EnriqueM11/Proyecto_final_robotica_industrial/README.md

# {Proyecto: Paletizado usando el brazo robotico UR5}



Este proyecto utiliza un robot UR5 para una sola línea de producción automatizada, con el objetivo de optimizar el proceso de empacado. Los sensores integrados en el sistema tienen la capacidad de detectar si los materiales son metálicos o no metálicos. Dependiendo de la detección, un servomotor guiará el objeto hacia la ruta adecuada en el proceso de paletizado. El robot UR5 es responsable de manipular los materiales, garantizando que cada uno se procese correctamente y se coloque en el pallet correspondiente, mejorando la eficiencia y precisión del sistema.

---

## 📋 Requisitos Previos

- Conocimientos necesarios: uso basico de herramientas mecanicas y electronicas, conocimientos basicos de programacion, preferentemente en lenguajes como C/C++ para Arduino y lenguajes de programacion de control de robots, conocimiento en electronica, sistemas de control y automatizacion industrial.

- Herramientas requeridas: cautín para soldadura de componentes electrónicos, maquinaria de manufactura, herramientas basicas (destornillador, pinzas, etc.).

- Componentes electrónicos o mecánicos necesarios: Arduino Mega, sensores inductivo y capacitivo, servomotores, motor de DC, resistencias.

- Software necesario: Arduino IDE, SolidWorks, URSIM.

---

## 📖 Introducción

El propósito de este proyecto es replicar una línea de empacado automatizada utilizando un robot UR5, con el objetivo de optimizar el proceso de paletizado en entornos industriales. En esta línea, los sensores detectan si los materiales son metálicos o no metálicos, y dependiendo de la detección, un servomotor dirige el material a la ruta adecuada. Este sistema automatizado mejora la eficiencia, precisión y seguridad al reducir la intervención humana, asegurando que los materiales se procesen correctamente y se coloquen en los pallets de forma ordenada y efectiva.

Nuestra motivación para construir este proyecto es poder ver de forma física el funcionamiento de una línea automatizada y llevar el concepto a la práctica. Al integrar el robot UR5, los sensores y los servomotores, buscamos aplicar nuestros conocimientos en robótica y automatización para entender mejor los procesos industriales. Además, este proyecto tiene aplicaciones en sectores como la manufactura, la logística y la industria automotriz, y proporciona una valiosa experiencia en el diseño, implementación y optimización de sistemas robotizados en entornos reales.

---

## 🔩 Materiales

Lista detallada de componentes y materiales con cantidades aproximadas:

- 1x Microcontrolador (Arduino UNO o mega)

- 1x Servo motor MG966R

- 1x Servo motor MG996R-2

- Cable Dupont (macho-macho y macho-hembra)

- 1x cable USB tipo A a tipo B

- 1x sensor infrarrojo E18-D80NK

- 1x sensor inductivo LJ12A3-4-Z/BX

- 1x Motor DC (24V)

- 20x cubos de aluminio

- 20x cubos de PLA

- 1x Protoboard

- Tornillos M5 x 12mm (x15)

- Tuercas M5 (x15)

- Tornillos M4 x 12mm (x15)

- Tuercas M4 (x15)

- Tornillos M3 x 12mm(x10)

- Tuercas M3 (x10)

- Fuente de alimentación (24V)

- Fuente de alimentación (7V)

- Maquinaria de manufactura

- Robot UR5

---
## 💾 Instalación de Software

**Descargar el Arduino IDE:**
- Ve al sitio web oficial de Arduino: https://www.arduino.cc/en/software.

- Selecciona el sistema operativo que estás usando (Windows, macOS, Linux).

- Haz clic en el botón de descarga correspondiente. Si usas Windows, puedes elegir entre el instalador o el archivo comprimido.

**Instalar el Arduino IDE:**

- Si descargaste el instalador: Haz doble clic en el archivo .exe descargado para iniciar la instalación.

- Acepta los términos de uso.

- Elige la carpeta de instalación y haz clic en "Install".

- Espera a que la instalación termine y haz clic en "Finish" para finalizar.

- Si descargaste el archivo comprimido:

- Extrae el contenido del archivo ZIP en una carpeta de tu elección.

- Dentro de la carpeta extraída, encontrarás el archivo arduino.exe. Haz doble clic para abrir el IDE.

Tambien se utilizo el software de SolidWorks para el diseño de las piezas, para hacer uso del software es necesario una licencia.

---

## ⚙️ Montaje y Ensamblado

**Preparacion inicial**

- Descargar y descomprimir la carpeta “Proyecto Final.zip”, la cual contiene todos los recursos necesarios para el ensamble y comprensión del sistema.
- Acceder a la subcarpeta “Proyecto Final Definitivo”.
- Reunir previamente todos los componentes de chapa metálica, junto con la pieza base denominada "Base Conveyor".

**Ensamblaje mecanico**

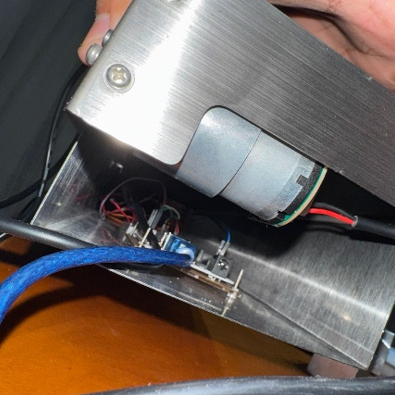
[picture p1: media/images/paso1_mecanico.png]


- Instalación del motor DC (24V):
  - Fijar el motor en su ubicación designada sobre la base metálica, asegurándose de que los engranajes reductores estén correctamente alineados y montados.
- Montaje del rodillo transportador:
  - Colocar el rodillo en el extremo opuesto al motor, formando así los dos extremos del sistema de tracción.
- Colocación de la lona de nailon:
  - Situar la lona entre los dos rodillos y tensarla adecuadamente utilizando las extensiones de ajuste incluidas en la estructura del conveyor.
- Instalación del protector de seguridad:
  - Ensamblar el protector superior o carcasa para garantizar la seguridad del usuario durante la operación del sistema.

Nota: Para mayor claridad, se recomienda consultar el modelo ensamblado en SolidWorks incluido en la carpeta .zip.

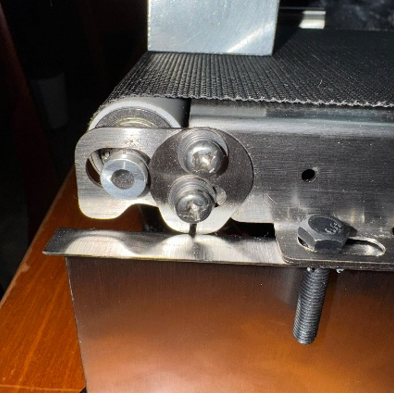
[picture p2: media/images/paso2_mecanico.png]


**Integracion electronica**

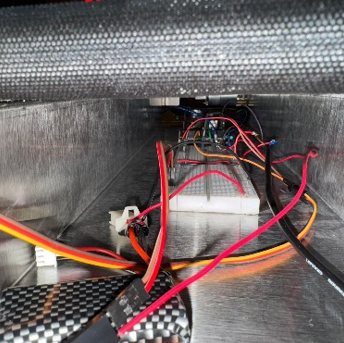
[picture p3: media/images/paso3_mecanico.png]


- Montaje de la electrónica:
  - Fijar la placa Arduino Mega, servomotores y demás elementos electrónicos sobre el soporte inferior metálico o plástico diseñado para tal fin.
- Instalación de guías de bloque:
  - Añadir las guías laterales necesarias para el alineamiento y transporte controlado de piezas sobre la banda.

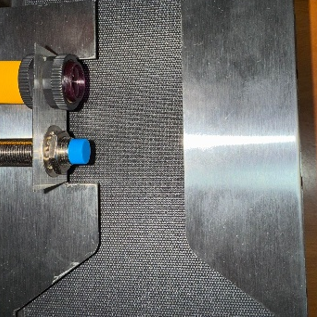
[picture p4: media/images/paso4_mecanico.png]


- Montaje de servomotores:
  - Ensamblar los servomotores junto con sus piezas de sujeción (brazos, soportes, etc.). Para mayor fuerza de torsión, utilizar cintillos plásticos (cinchos de presión) que brinden mayor firmeza y estabilidad.
  
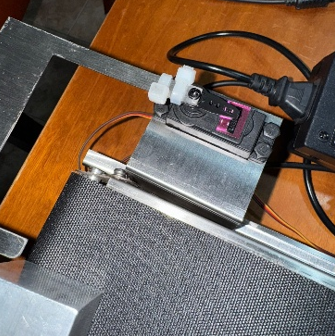
[picture p5: media/images/paso5_mecanico.png]

 
- Fijación de servomotores:
  - Colocar los servomotores ya armados en sus posiciones definidas, asegurando una orientación adecuada para la tarea de manipulación de piezas.
- Instalación de sensores:
  - Fijar correctamente los sensores inductivos (NPN y PNP) en las ubicaciones previamente diseñadas, asegurándose de realizar las conexiones correspondientes con divisores de voltaje, si se alimentan con 24V.

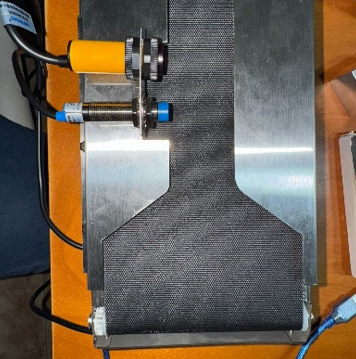
[picture p6: media/images/paso6_mecanico.png]


**Puesta en marcha**
- Pruebas de montaje y funcionamiento:
  - Verificar que todos los componentes estén bien fijados y alineados. Encender el sistema para realizar pruebas de movimiento del conveyor, activación de sensores y respuesta de los servomotores.
- Finalización del montaje:
  - Una vez comprobado el correcto funcionamiento del sistema, cerrar cualquier cubierta protectora adicional y asegurar las conexiones finales.

¡Conveyor listo para operar!
Disfrute del funcionamiento automatizado del conveyor diseñado, ideal para clasificación y manejo de piezas en proyectos universitarios o de prototipado industrial.

### 🔌 Conexiones Eléctricas

Diagrama esquemático y tabla de conexiones entre componentes:

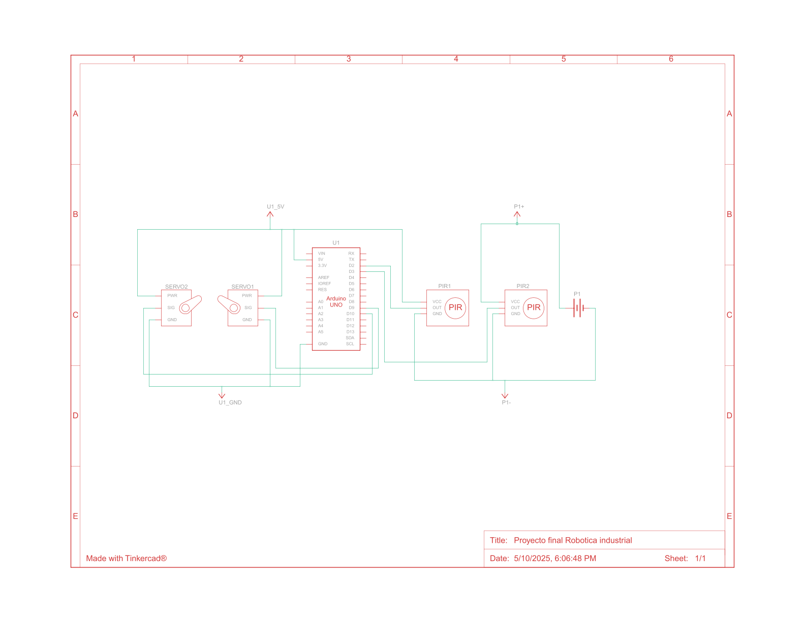
[picture p7: media/images/Proyecto final robotica industrial.png]


Porque el diagrama se hizo mediante thinkercad, no cuenta con los sensores correspondientes pero el sensor llamado "PIR2" seria el sensor inductivo

Tabla de conexiones entre componentes

Alimentacion:
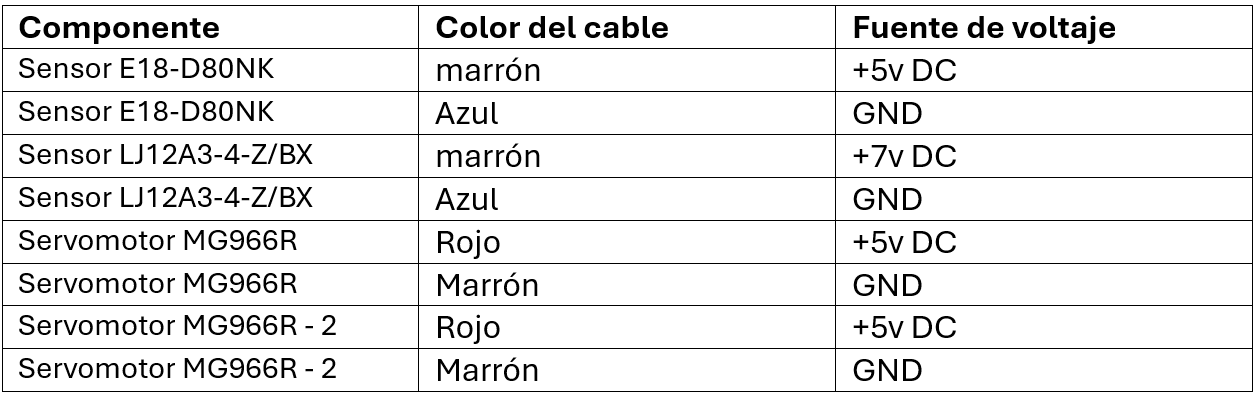
[picture p8: media/images/Tabla_voltajes.png]


Datos:

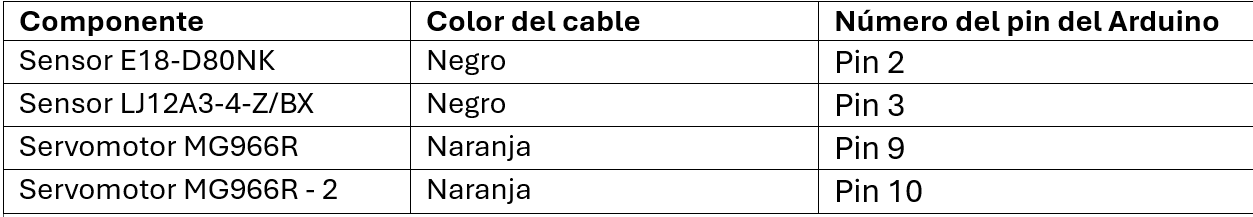
[picture p9: media/images/Tabla_datos.png]


---

## 💻 Programación

**Tutorial de como usar el wizard de paletizado en el teach pendant del robot fisico**

- **Paso 1:** Al momento de iniciar el robot, tiene que salir la siguiente pantalla y se tiene que presionar al boton "Program robot" que esta encerrado en rojo

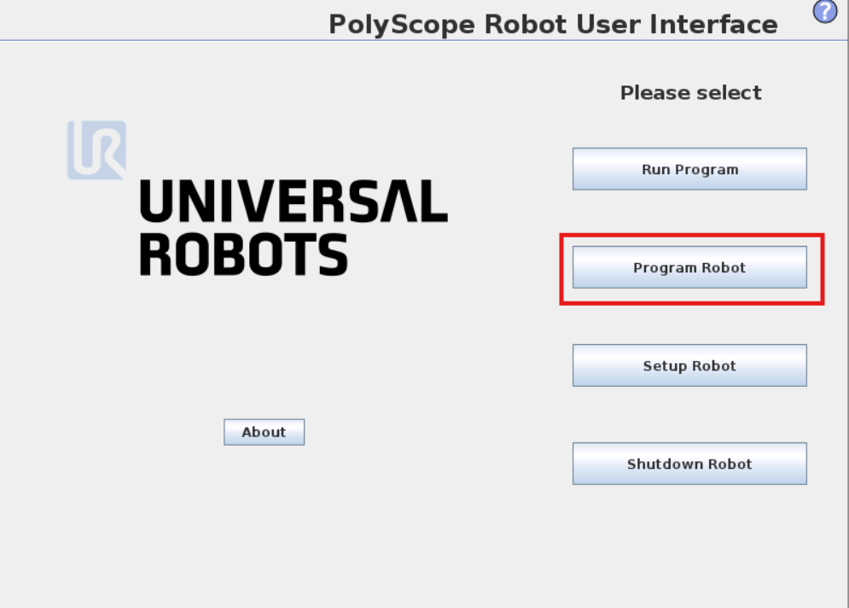
[picture p10: media/images/Paso1.png]
  
- **Paso 2:** Saldra la siguiente ventan y se presiona "Empty program"

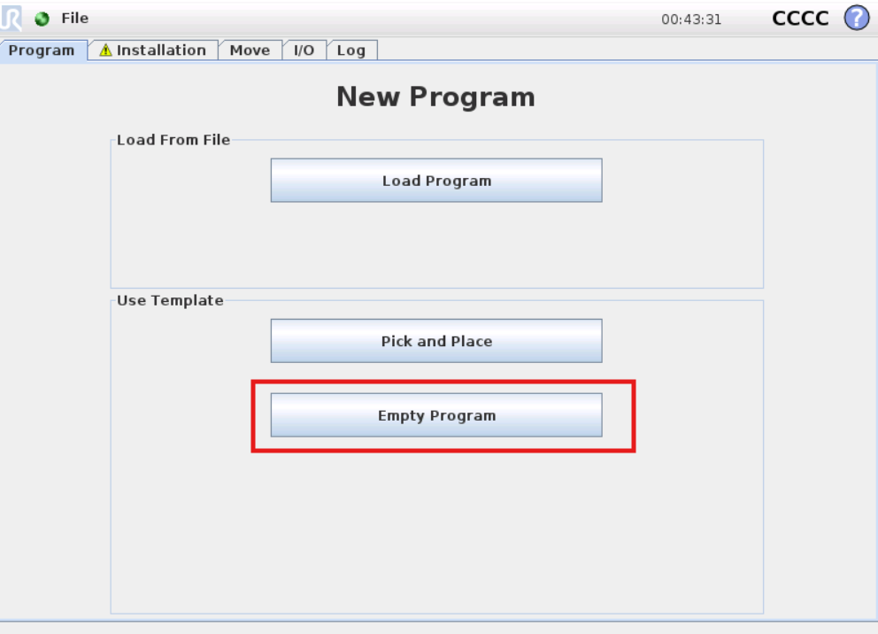
[picture p11: media/images/Paso2.png]
  

- **Paso 3:** Lo mandara a la ventana del teach pendant del robot para utilizar el wizard del paletizado tiene que presionar Structure -> Wizards -> Pallet

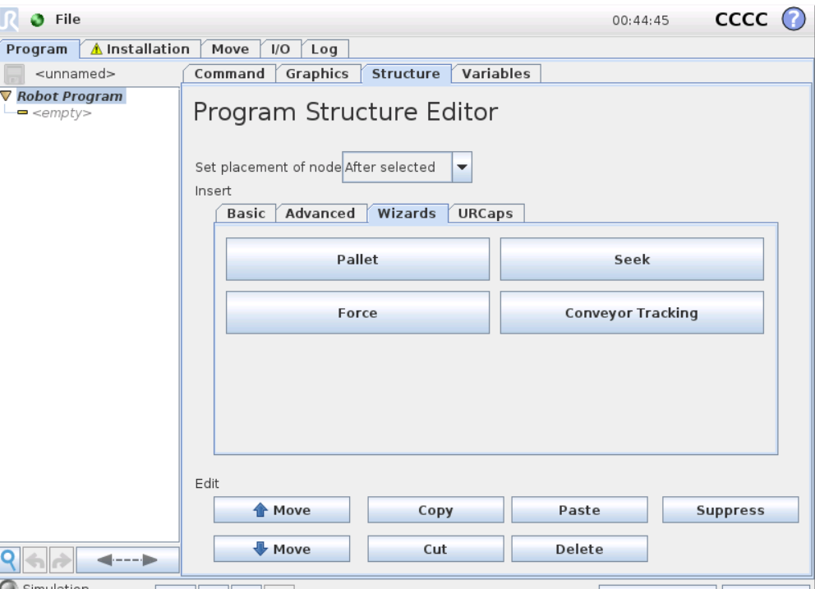
[picture p12: media/images/paso3.png]
  

- **Paso 4:** Le saldra la siguiente ventana, en el cual le preguntara el tipo de patron que va a llenar el pallet. En este caso se selecciono el de linea.

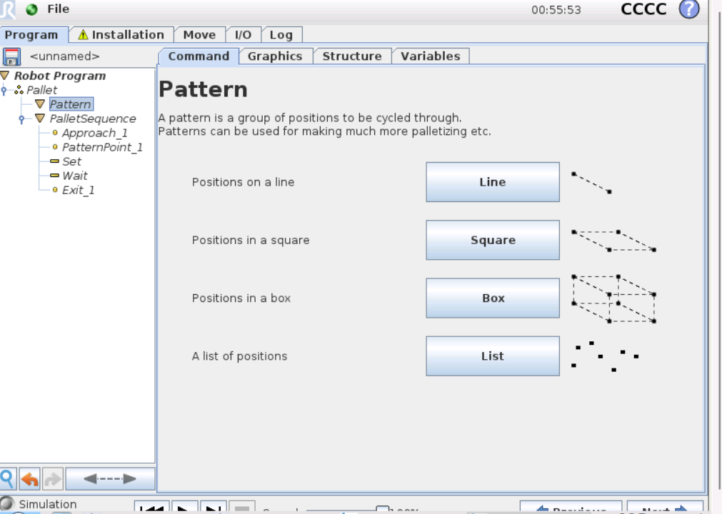
[picture p13: media/images/Paso4.png]


- **Paso 5:** El wizard le preguntara cuantas cajas va a acomodar, aqui se puede el valor que quiera el usuario.

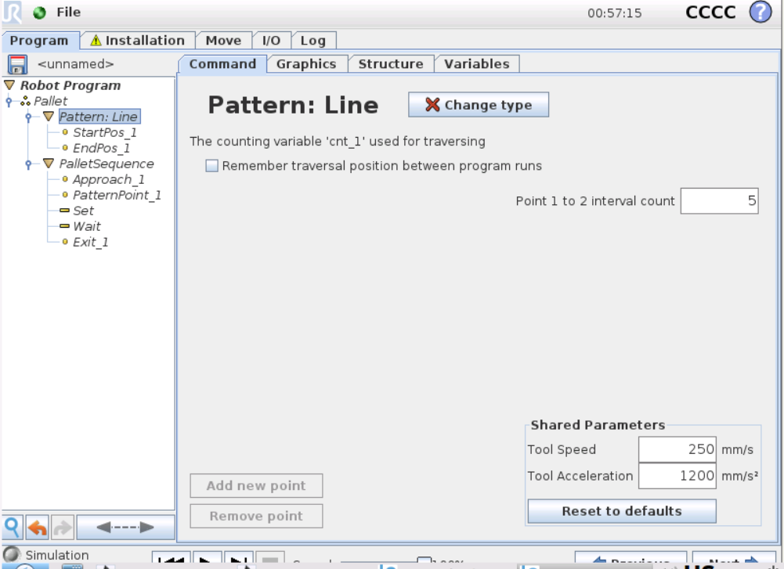
[picture p14: media/images/paso5.png]
  

- **Paso 6:** Despues tendra que mover el robot para marcarle el punto de inicio del paletizado

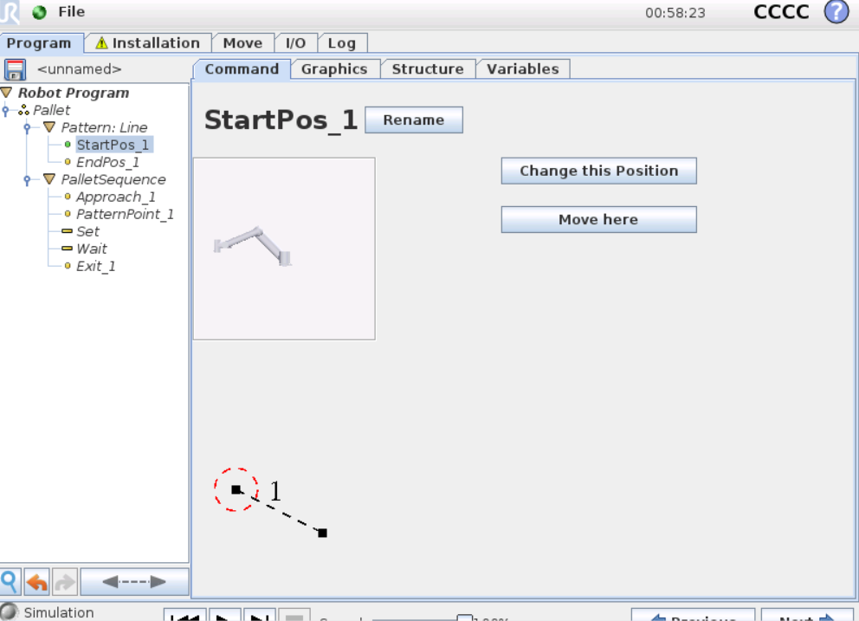
[picture p15: media/images/paso6.png]
  

- **Paso 7:** De igual manera tendra que mover el robot para marcar el punto final del paletizado

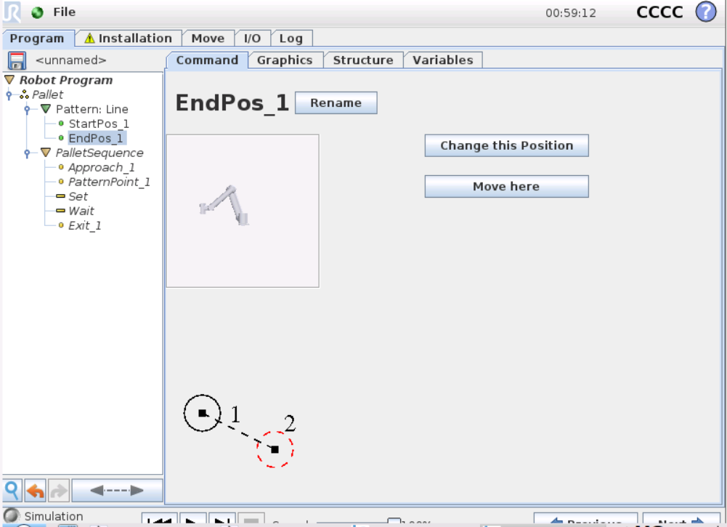
[picture p16: media/images/paso7.png]
  

- **Paso 8:** En las secciones de "Approach_1" y "Pattern point_1" el waypoint es el mismo que se utiliza en el paso 6

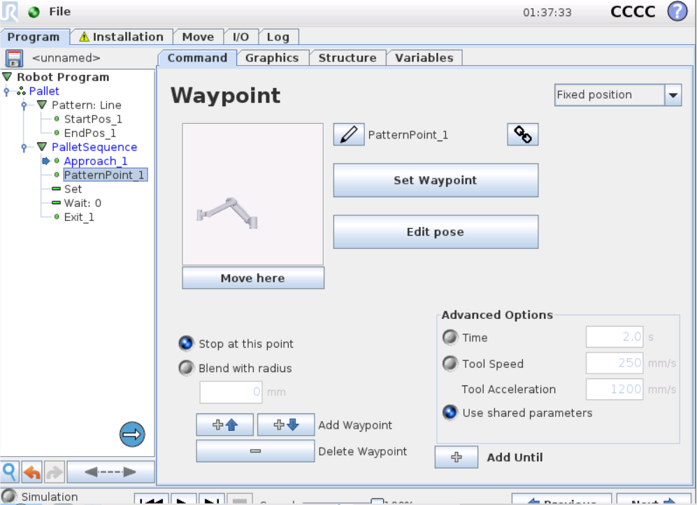
[picture p17: media/images/paso8.png]
  
- **Paso 9:** En las secciones "Set" y "Wait" es para declarar acciones. En el caso de set es para que realice una accion antes de seguir con el codigo y en el caso de wait es para que el robot espere cierto tiempo antes de seguir con el codigo.

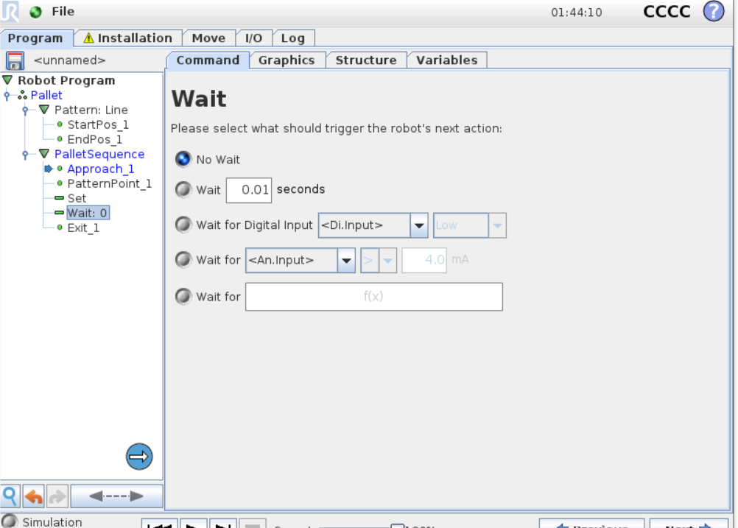
[picture p18: media/images/paso9.png]
  

- **Paso 10:** En la seccion de "Exit_1" aqui se declara un punto en el cual el robot va a ir despues de haber colocado una caja.

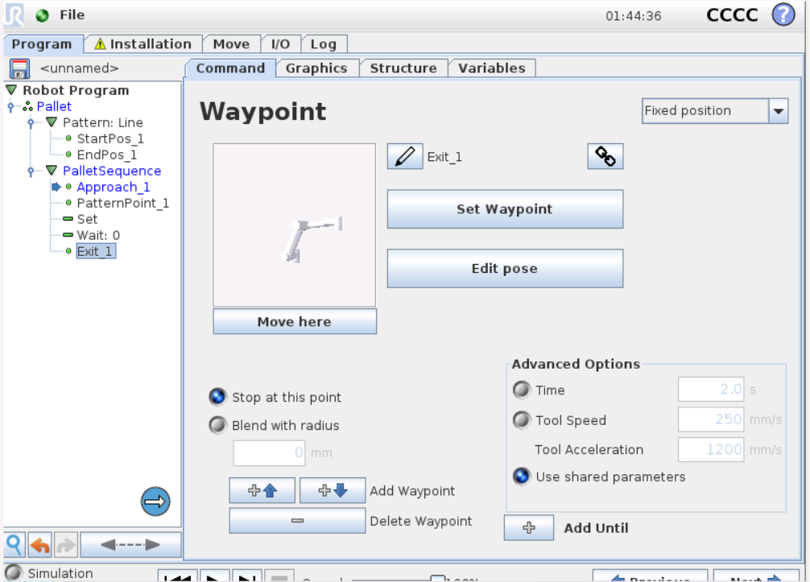
[picture p19: media/images/paso10.png]
  
  
¡Listo! Ya esta configurado el pallet solo queda en dar RUN al programa

**Explicacion breve del funcionamiento del codigo en Arduino**

Este apartado solamente se hablara sobre las partes importantes del codigo del funcionamiento de la banda de produccion, para mas detalles puede ver el codigo llamado "banda_de_produccion.ino" dentro de la carpeta src.

- Aqui detecta el estado de los sensores para verificar si ha habido algun cambio. El sensor inductivo esta bajo la variable llamada "sensorNPN" y el sensor infrarrojo esta bajo la variable llamada "sensorPNP".
```
bool pnpDetecta = digitalRead(sensorPNP) == LOW; 
bool npnDetecta = digitalRead(sensorNPN) == LOW;
```

- Cuando solo el sensor PNP detecta, el sistema activa únicamente el servo2, que realiza un movimiento de 0° a 90° y regresa. Este podría representar una ruta de clasificación específica para ese tipo de material.
```
if (pnpDetecta && !npnDetecta) {
    
    Serial.println("Solo PNP detecta - Servo 2");

    delay(7000);

    for (int pos = 0; pos <= 90; pos++) {
      servo2.write(pos);
      delay(5);
    }

    delay(100);

    for (int pos = 90; pos >= 0; pos--) {
      servo2.write(pos);
      delay(5);
    }

  } 
```

- Si ambos sensores detectan simultáneamente, el sistema considera un caso especial, para este caso detecta que es un objeto metalico. Primero actúa el servo2, luego el servo1, y al final ambos regresan a la posición inicial.

```
else if (pnpDetecta && npnDetecta) {
    
    Serial.println("Ambos sensores - Servos 1 y 2");

    delay(50);

    for (int pos = 0; pos <= 90; pos++) {
      servo2.write(pos);
      delay(4);
    }

    delay(8000);

    for (int pos = 0; pos <= 90; pos++) {
      servo1.write(pos);
      delay(5);
    }

    delay(8000);

    for (int pos = 90; pos >= 0; pos--) {
      servo1.write(pos);
      servo2.write(pos);
      delay(5);
    }
  } 
```
---

## ✅ Conclusión

Este proyecto demostró la exitosa implementación de un sistema automatizado de clasificación y direccionamiento de materiales en una línea de empaquetamiento. Mediante la integración de un Arduino, sensores  y servomotores, se logró distinguir eficazmente entre objetos metálicos y plásticos, desviando cada tipo hacia conductos específicos.
Este sistema híbrido, que combina la versatilidad y la capacidad de detección del Arduino con la precisión y la manipulación avanzada del robot industrial UR5, representa una solución eficiente y adaptable para optimizar los procesos de empaquetamiento. La automatización de la clasificación inicial mediante sensores y actuadores controlados por Arduino permitió un flujo de trabajo continuo y una preparación adecuada para la etapa de paletizado robótico. La implementación de este tipo de sistemas contribuye significativamente a la mejora de la productividad, la reducción de errores y la optimización de los recursos en entornos de producción industrial.

---

## 🔜 Mejoras futuras

- Integración de Sensor de Color: Ampliar la capacidad de clasificación para incluir la discriminación de materiales plásticos basada en su color, permitiendo una segregación más granular.
- Implementación de Visión Artificial: Incorporar un sistema de visión basado en cámaras y procesamiento de imágenes para analizar la forma, el tamaño y el tipo específico de los objetos, incrementando la precisión de la clasificación.
- Control de Velocidad Variable de la Banda Transportadora: Implementar un sistema que ajuste dinámicamente la velocidad de la banda en función del tipo de material y la demanda del sistema de paletizado, optimizando el flujo de producción
- Mecanismo de Desviación Mejorado: Rediseñar o modificar el sistema de desviación para asegurar una manipulación más suave de los objetos, minimizando el riesgo de daños, especialmente en materiales frágiles.
- Comunicación Bidireccional Robusta: Establecer un protocolo de comunicación más complejo entre el Arduino y el robot UR5 para el intercambio de información detallada sobre las características de los materiales (tipo, orientación) y el estado del proceso de paletizado
- Desarrollo de una Interfaz Hombre-Máquina (HMI): Implementar una interfaz gráfica intuitiva para facilitar la supervisión del sistema, la visualización de datos de producción, la configuración de parámetros y el diagnóstico de posibles fallos.

## ⚠️ Advertencia

Como se indica en la licencia MIT, este software/hardware se proporciona **sin ningún tipo de garantía**. Por lo tanto, ningún colaborador es responsable de **cualquier daño a tus componentes, materiales, PC, etc..**.

---

## 📚 Recursos Adicionales

Craig, J. J. (2014). Introduction to robotics: Mechanics and control (4th ed.). Pearson Education.

Siciliano, B., & Khatib, O. (Eds.). (2016). Springer handbook of robotics (2nd ed.). Springer. https://doi.org/10.1007/978-3-319-32552-1

Universal Robots. (2024). UR5e Technical specifications. Recuperado de https://www.universal-robots.com/media/50588/ur5_en.pdf

RoboDK. (2024). Robot simulation and offline programming documentation.

Niku, S. B. (2020). Introduction to robotics: Analysis, control, applications (3rd ed.). Wiley

---

## 👥 Autores del proyecto

Enrique Mendoza Sánchez

Edgar Jiménez Guridi

Carlos Uriel Herrera Cuahuizo

---

## 📬 Contacto

¿Tienes dudas o sugerencias?

- 📧 Correo electrónico: cesar.martinez@udlap.mx

---
