EnriqueM11/Proyecto_final_robotica_industrial/(notices)

Notices in the files:
README.md:
MIT License
